daffa-d/PCA9685_ESP32/main/main.step

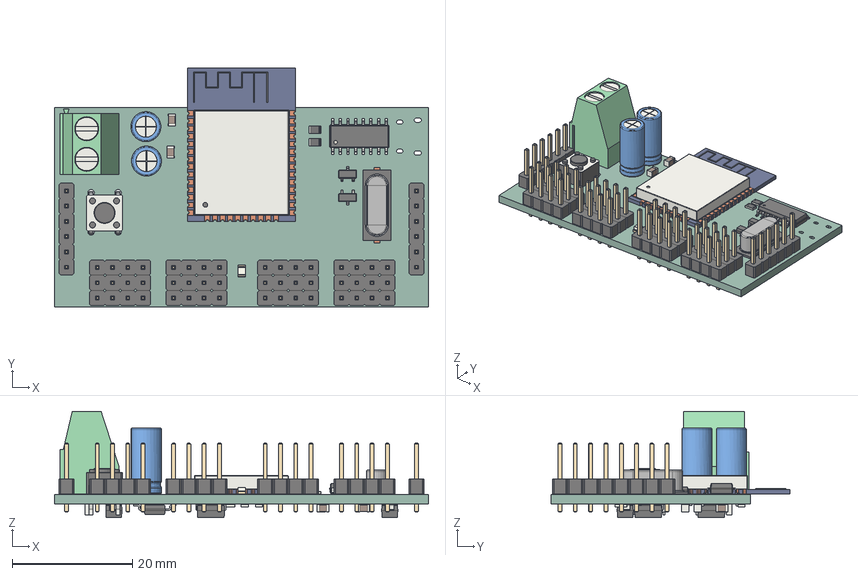
[picture p3: CAD file, 2025-03-05]
main/main.step
62.2 x 39.7 x 17.7 mm
PinHeader_1x04_P254mm_Vertical x 12
SOT_23 x 2
PinHeader_1x06_P254mm_Vertical x 2
SW_PUSH_6mm
ESP32-WROOM-32
R_0805_2012Metric x 5
C_Radial_D50mm_H110mm_P200mm x 2
TerminalBlock_Phoenix_MKDS_15_2_508_1x02_P508mm_Horizontal
Crystal_SMD_HC49-SD
C_0805_2012Metric x 8
LED_0805_2012Metric
SOIC_16_39x99mm_P127mm
D_SMA x 3
SOT_223
main_PCB
