daffa-d/PCA9685_ESP32/main/Main/main.pdf

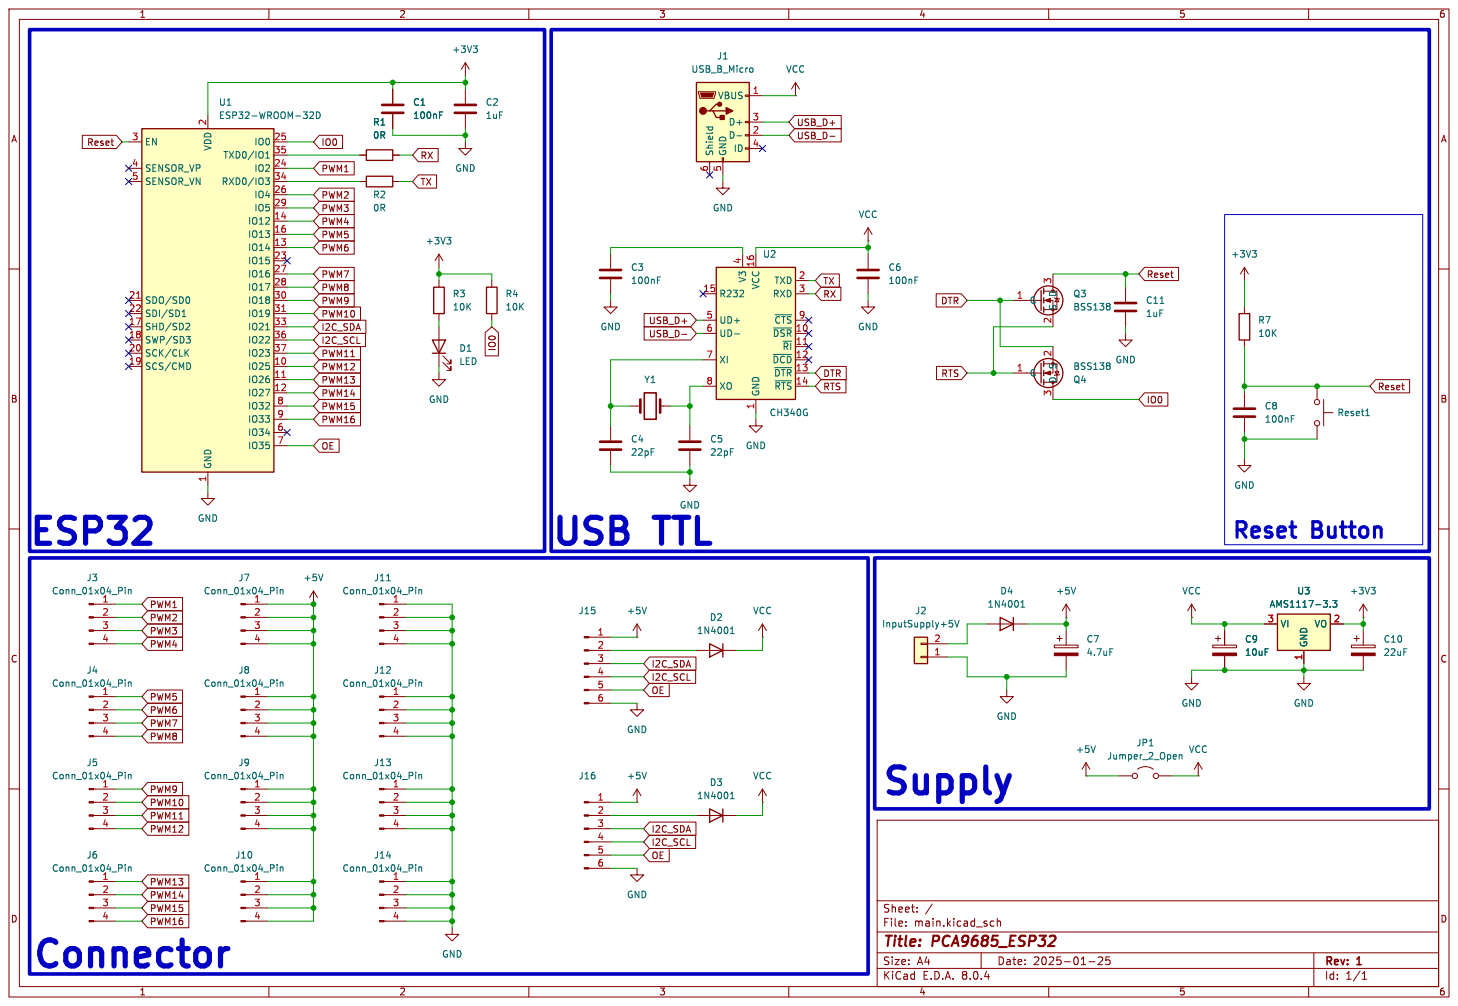
[picture p4: page 1]

2 SCK/CLK 20 SDO/SD0 21 SDI/SD1 22
PWM15 PWM16 PWM9 PWM6

1 ~{DSR} 10 ~{RI} 11 ~{DCD} 12 ~{DTR} 13 ~{RTS} 14 R232 15 VCC 16 TXD 2 RXD 3 V3

4 UD+ 5 UD- 6 XI 7 XO 8 ~{CTS}9 U2CH340G Reset1 GND
