daffa-d/PCA9685_ESP32/main/main.kicad_pcb

## KiCad design main/main.kicad_pcb (2025-03-05)

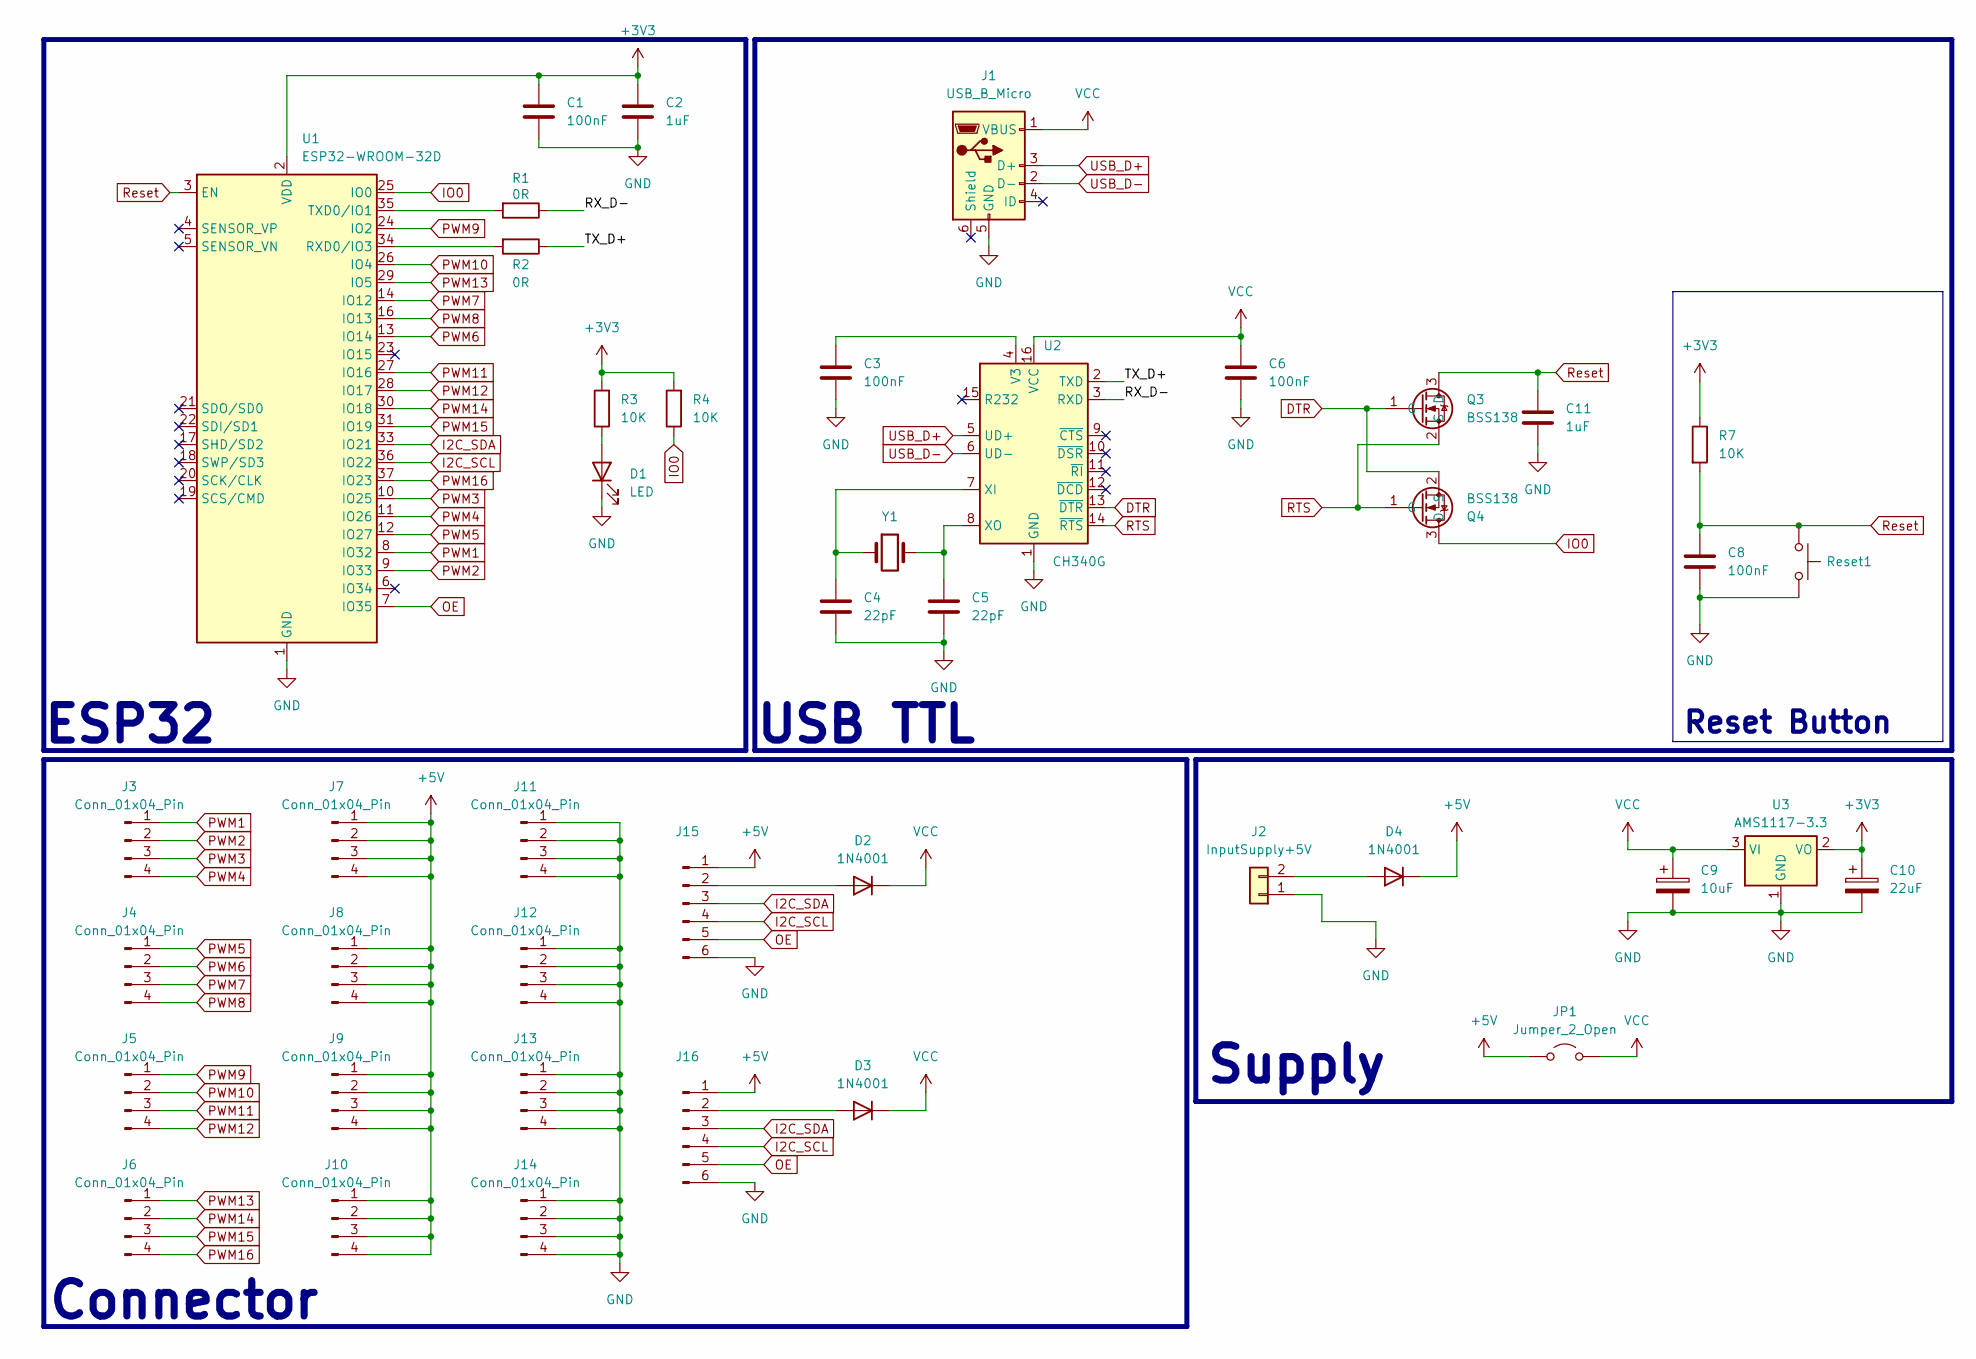
[picture p5: schematic main.kicad_sch, PCA9685_ESP32]

Parts:
C1, C3, C6, C8: 100nF; C_0805_2012Metric_Pad1.18x1.45mm_HandSolder
C2, C11: 1uF; C_0805_2012Metric_Pad1.18x1.45mm_HandSolder
C4, C5: 22pF; C_0805_2012Metric_Pad1.18x1.45mm_HandSolder
C9: 10uF; C_Radial_D5.0mm_H11.0mm_P2.00mm
C10: 22uF; C_Radial_D5.0mm_H11.0mm_P2.00mm
D1: LED; LED_0805_2012Metric_Pad1.15x1.40mm_HandSolder
D2, D3, D4: 1N4001; D_SMA_Handsoldering
J1: USB_B_Micro; USB_Micro-B_Amphenol_10103594-0001LF_Horizontal
J2: InputSupply+5V; TerminalBlock_Phoenix_MKDS-1,5-2-5.08_1x02_P5.08mm_Horizont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
J3, J4, J5, J6, J7, J8, J9, J10, J11, J12, J13, J14: Conn_01x04_Pin; PinHeader_1x04_P2.54mm_Vertical
J15, J16: Conn_01x06_Pin; PinHeader_1x06_P2.54mm_Vertical
JP1: Jumper_2_Open; SolderJumper-2_P1.3mm_Open_TrianglePad1.0x1.5mm
Q3, Q4: BSS138; SOT-23
R1, R2: 0R; R_0805_2012Metric_Pad1.20x1.40mm_HandSolder
R3, R4, R7: 10K; R_0805_2012Metric_Pad1.20x1.40mm_HandSolder
Reset1: SW_Push; SW_PUSH_6mm
U1: ESP32-WROOM-32D; ESP32-WROOM-32
U2: CH340G; SOIC-16_3.9x9.9mm_P1.27mm
U3: AMS1117-3.3; SOT-223-3_TabPin2
Y1: Crystal; Crystal_SMD_HC49-SD

Connections:
+3V3: C1.1, C2.1, C10.1, R3.2, R4.2, R7.1, U1.2 (VDD), U3.2 (VO)
+5V: D4.1 (K), J7.1, J7.2, J7.3, J7.4, J8.1, J8.2, J8.3, J8.4, J9.1, J9.2, J9.3, J9.4, J10.1, J10.2, J10.3, J10.4, J15.1, J16.1, JP1.1 (A)
/RX_D-: R1.1, U2.3 (RXD)
/TX_D+: R2.1, U2.2 (TXD)
DTR: Q3.1 (G), Q4.2 (S), U2.13 (~DTR); also elsewhere on the board
GND: C1.2, C2.2, C3.2, C4.2, C5.2, C6.2, C8.2, C9.2, C10.2, C11.2, D1.1 (K), J1.5 (GND), J2.1, J11.1, J11.2, J11.3, J11.4, J12.1, J12.2, J12.3, J12.4, J13.1, J13.2, J13.3, J13.4, J14.1, J14.2, J14.3, J14.4, J15.6, J16.6, Reset1.2, U1.1 (GND), U1.15 (GND), U1.38 (GND), U1.39 (GND), U2.1 (GND), U3.1 (GND)
I2C_SCL: J15.4, J16.4, U1.36 (IO22)
I2C_SDA: J15.3, J16.3, U1.33 (IO21)
IO0: Q4.3 (D), R4.1, U1.25 (IO0); also elsewhere on the board
unnamed: D1.2 (A), R3.1
unnamed: D2.2 (A), J15.2
unnamed: D3.2 (A), J16.2
unnamed: D4.2 (A), J2.2
unnamed: R2.2, U1.34 (RXD0/IO3)
unnamed: R1.2, U1.35 (TXD0/IO1)
unnamed: C3.1, U2.4 (V3)
unnamed: C4.1, U2.7 (XI), Y1.1
unnamed: C5.1, U2.8 (XO), Y1.2
OE: J15.5, J16.5, U1.7 (IO35)
PWM1: J3.1, U1.8 (IO32)
PWM2: J3.2, U1.9 (IO33)
PWM3: J3.3, U1.10 (IO25)
PWM4: J3.4, U1.11 (IO26)
PWM5: J4.1, U1.12 (IO27)
PWM6: J4.2, U1.13 (IO14)
PWM7: J4.3, U1.14 (IO12)
PWM8: J4.4, U1.16 (IO13)
PWM9: J5.1, U1.24 (IO2)
PWM10: J5.2, U1.26 (IO4)
PWM11: J5.3, U1.27 (IO16)
PWM12: J5.4, U1.28 (IO17)
PWM13: J6.1, U1.29 (IO5)
PWM14: J6.2, U1.30 (IO18)
PWM15: J6.3, U1.31 (IO19)
PWM16: J6.4, U1.37 (IO23)
RTS: Q3.2 (S), Q4.1 (G), U2.14 (~RTS); also elsewhere on the board
Reset: C8.1, C11.1, Q3.3 (D), R7.2, Reset1.1, U1.3 (EN); also elsewhere on the board
USB_D+: J1.3 (D+), U2.5 (UD+)
USB_D-: J1.2 (D-), U2.6 (UD-)
VCC: C6.1, C9.1, D2.1 (K), D3.1 (K), J1.1 (VBUS), JP1.2 (B), U2.16 (VCC), U3.3 (VI)

Notes on the sheet:
Connector
Reset Button
ESP32
USB TTL
Supply

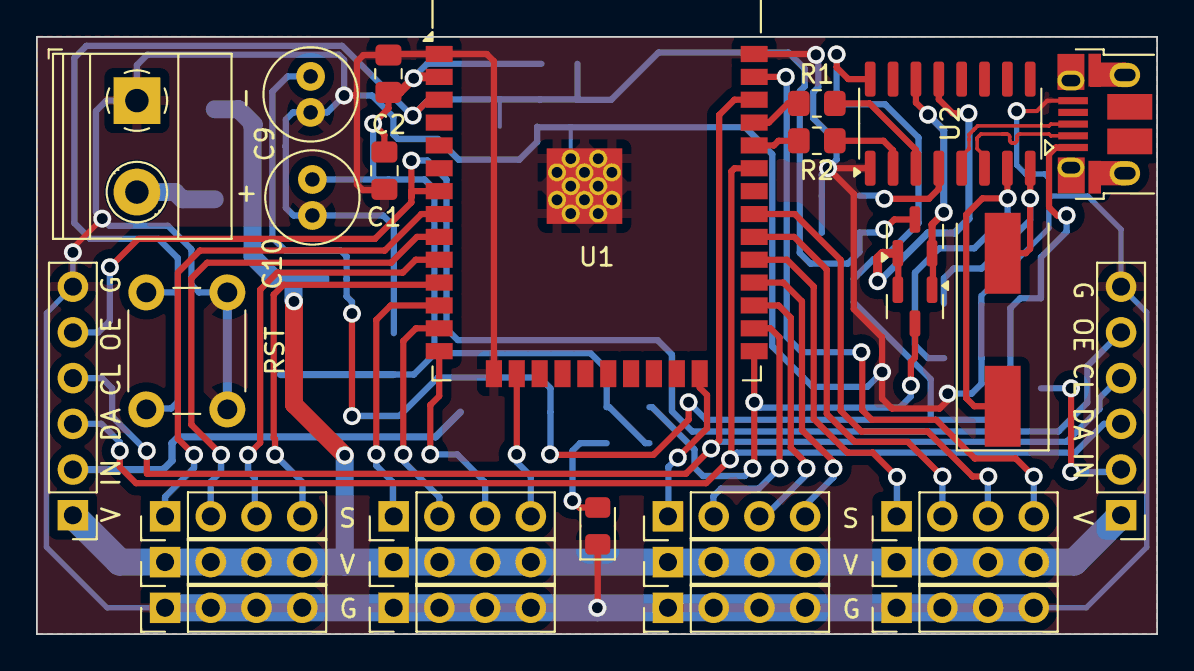
[picture p6: board main.kicad_pcb from above]

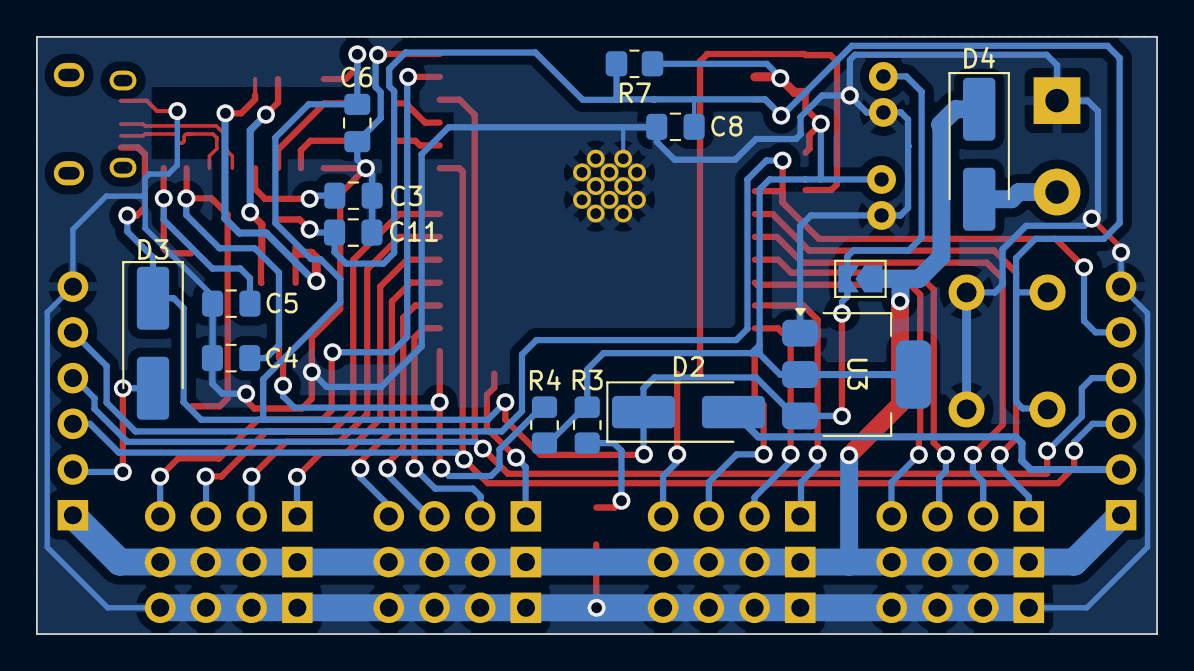
[picture p7: board main.kicad_pcb from below]

Board: 2 copper layers, 62.2 x 33.2 mm, 43 parts (14 on the bottom side), 40 nets.

Other parts of the board:
Q1, Q2: BSS138; SOT-23

Their connections:
DTR: Q1.1 (G), Q2.2 (S); also elsewhere on the board
IO0: Q2.3 (D); also elsewhere on the board
RTS: Q1.2 (S), Q2.1 (G); also elsewhere on the board
Reset: Q1.3 (D); also elsewhere on the board
